guilhermedopp/alerta-calor/hardware/README.md

# Hardware

- `mapa_protoboard_bancada.png`: ligações da montagem de bancada (ESP32 DevKit plugado na protoboard, DHT11 no D26, PIR no D27, buzzer no D25).
- `tutorial_montagem_bancada.pdf`: passo a passo da montagem física da bancada.

- [`kicad/`](kicad/): placa de circuito da caixa (KiCad 10), 40 × 30 mm, já roteada.

**Placa final (caixa v4):** ESP32-C3 SuperMini, sensor AHT20 + BMP280, LED RGB difuso, buzzer ativo 5 V, botão 12 × 12 mm e PIR AM312, numa placa de circuito própria com o ESP32 em soquete. Peças compradas para 3 protótipos (recebidas em 09/11/2026); cada caixa sai por cerca de R$ 35 a 44 em peças.
