guilhermedopp/alerta-calor/caixa_3d/README.md

# Caixa v4 (70 × 69 × 40 mm)

Caixa para impressão 3D, com encaixes impressos junto com o corpo e a tampa para a placa perfurada, o sensor AHT20, o buzzer e o PIR (sem parafusos na placa).

- `imprimir/`: STL do corpo, tampa, painel e disco.
- `imagens/aparencia_caixa_v4.png`: aparência por fora e com os componentes.
- `imagens/medidas_caixa_v4.png`: desenho cotado (frente, lateral e tampa).
- `imagens/encaixes_internos_v4.png`: encaixes por dentro.
- `LEIA-ME_v4b.txt`: o que mudou em relação à v3 e a ordem de montagem.
