guilhermedopp/alerta-calor/docs/README.md

# Documentos

- `Proposta_AI4Good_Alerta_de_Calor.pdf`: proposta do projeto (problema, solução, impacto, plano e limitações).
- `Implementacao_IA_Alerta_de_Calor.pdf`: documento técnico de como as duas IAs serão implementadas.
