guilhermedopp/alerta-calor/caixa_3d/imagens/encaixes_internos_v4.png

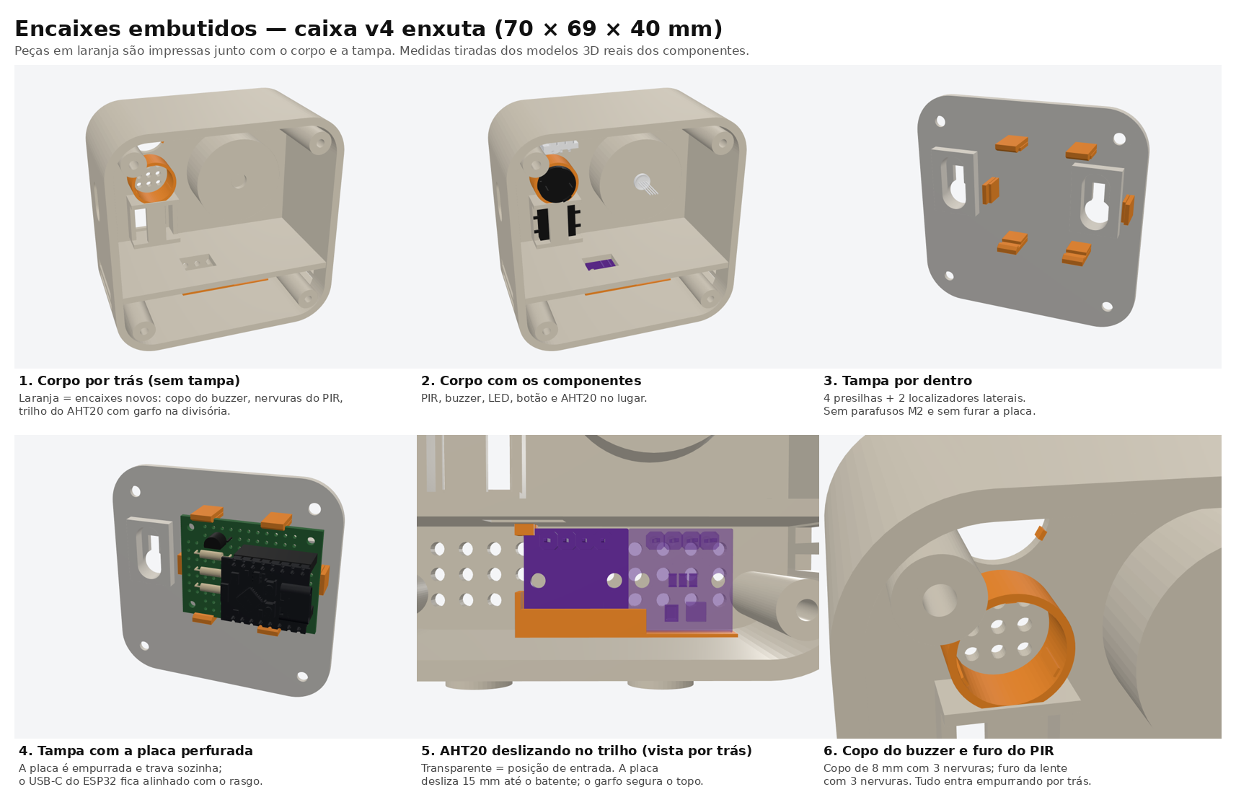
caixa_3d/imagens/encaixes_internos_v4.png
