guilhermedopp/alerta-calor/caixa_3d/imagens/medidas_caixa_v4.png

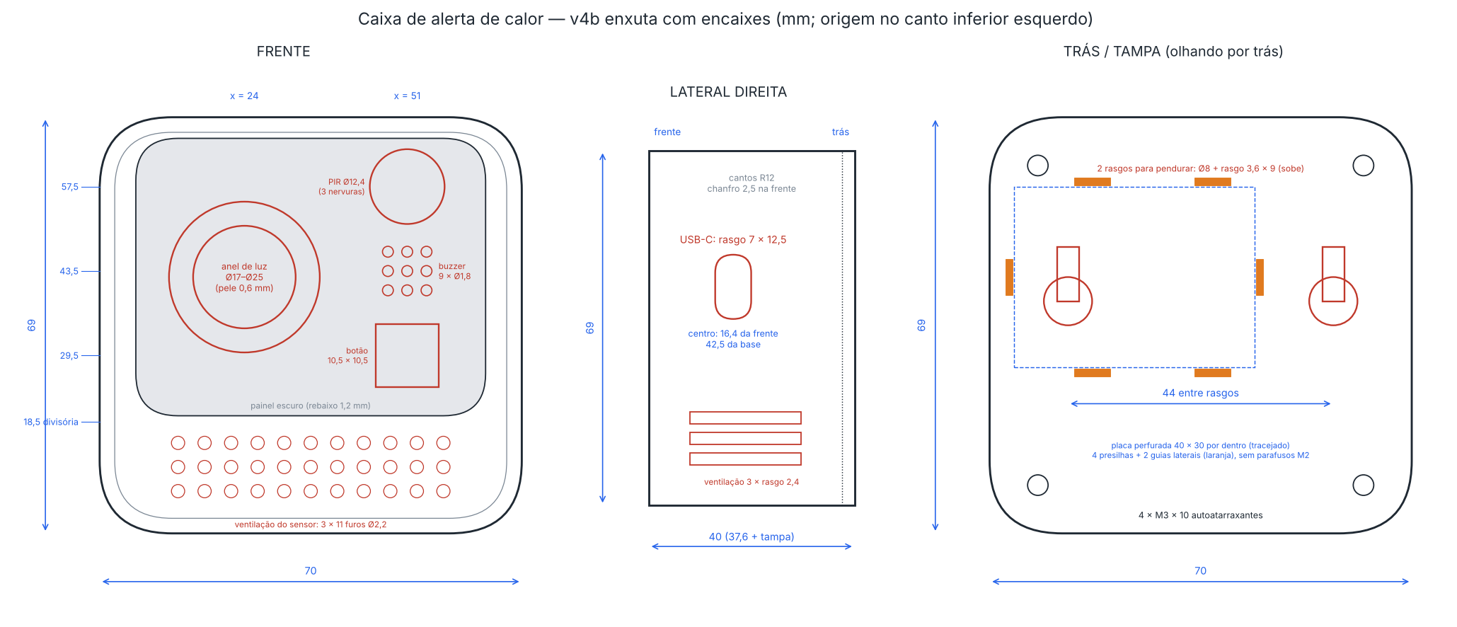
caixa_3d/imagens/medidas_caixa_v4.png
