guilhermedopp/alerta-calor/hardware/mapa_protoboard_bancada.png

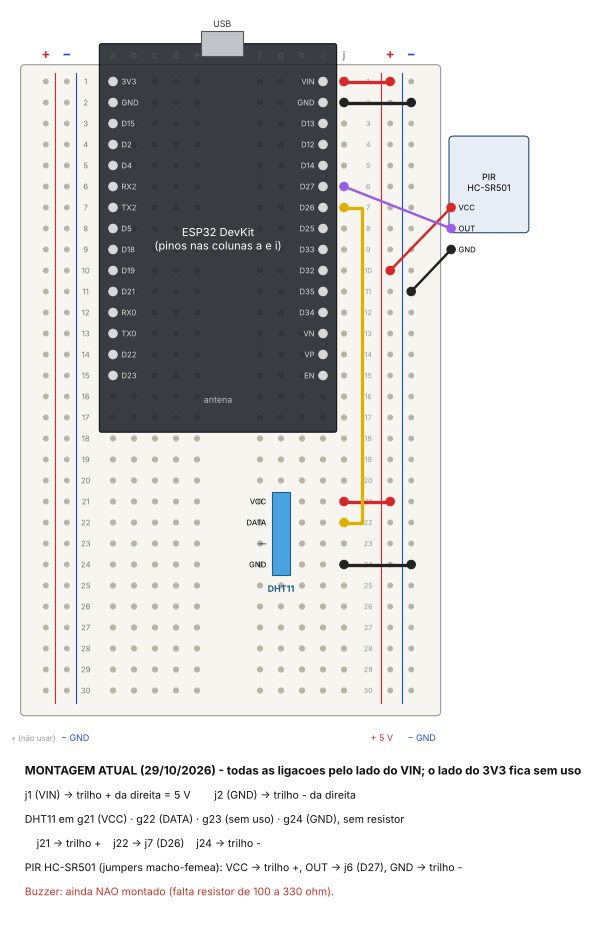
hardware/mapa_protoboard_bancada.png
