guilhermedopp/alerta-calor/caixa_3d/imprimir/caixa_alerta_corpo_v4b.stl

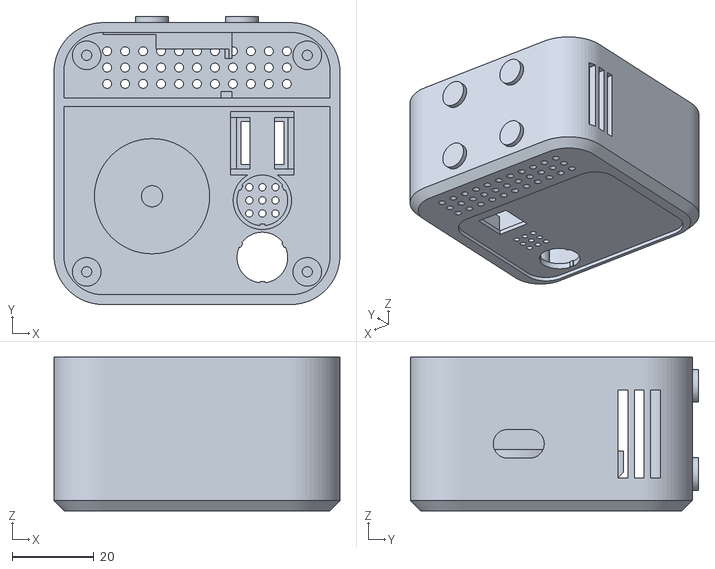
[picture p10: CAD file, 2026-10-30]
caixa_3d/imprimir/caixa_alerta_corpo_v4b.stl
70.0 x 70.5 x 37.6
