guilhermedopp/alerta-calor/caixa_3d/imprimir/caixa_alerta_disco_v4b.stl

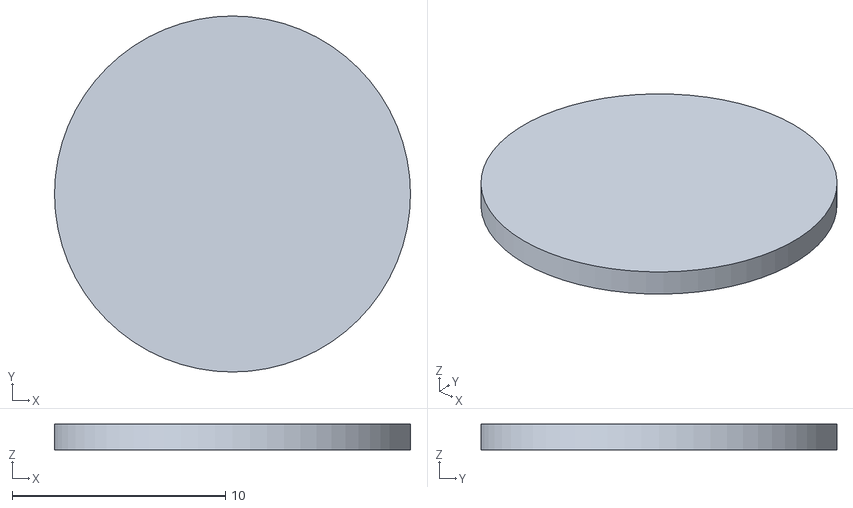
[picture p11: CAD file, 2026-10-30]
caixa_3d/imprimir/caixa_alerta_disco_v4b.stl
16.7 x 16.7 x 1.20
