guilhermedopp/alerta-calor/caixa_3d/imprimir/caixa_alerta_painel_v4b.stl

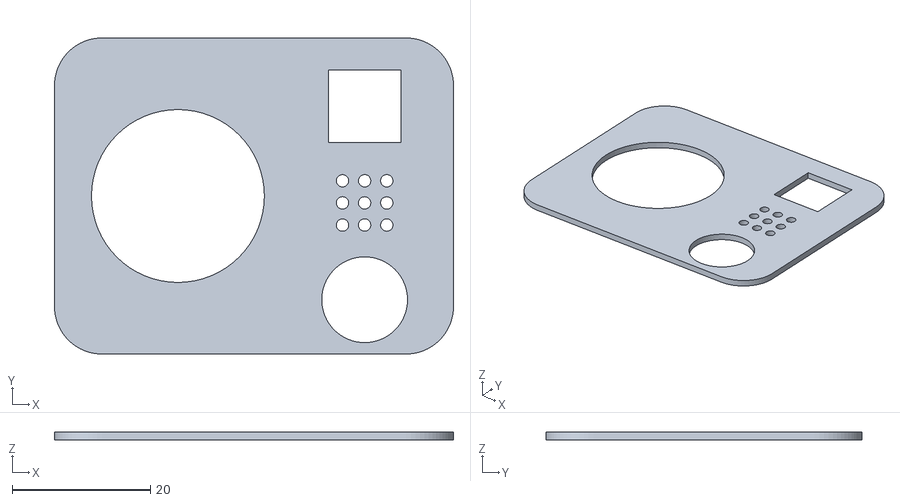
[picture p12: CAD file, 2026-10-30]
caixa_3d/imprimir/caixa_alerta_painel_v4b.stl
57.7 x 45.7 x 1.20
