guilhermedopp/alerta-calor/caixa_3d/imprimir/caixa_alerta_tampa_v4b.stl

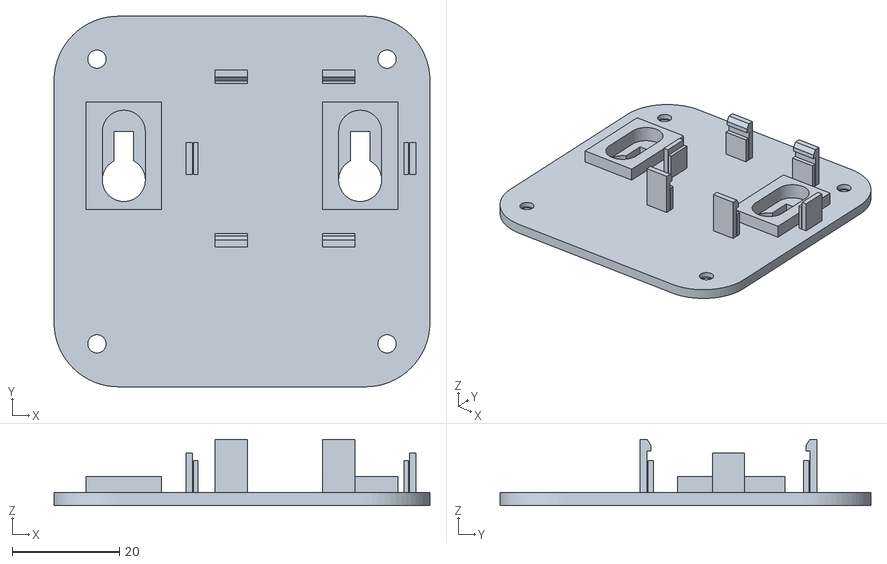
[picture p13: CAD file, 2026-10-30]
caixa_3d/imprimir/caixa_alerta_tampa_v4b.stl
70.0 x 69.0 x 12.3
