guilhermedopp/alerta-calor/analise_maceio/resultados/resultados_poisson.csv

desfecho | exposicao | n_dias | RR | IC95_inf | IC95_sup | p
Circulatórias | tmax | 3338 | 1.0083863294249602 | 0.9960839506184546 | 1.0208406517741808 | 0.1823724984077736
Circulatórias | tmax_l02 | 3317 | 1.006322028506237 | 0.9904987706607143 | 1.0223980635345917 | 0.43575785036854253
Circulatórias | icmax_l02 | 2755 | 1.0098879071161362 | 0.9976052466841611 | 1.0223217934441147 | 0.1150324009631648
Circulatórias | dia_quente | 3338 | 1.0421193254281358 | 0.9660429692794495 | 1.1241867318187988 | 0.2860886018394475
Respiratórias | tmax | 3338 | 0.9953907318713809 | 0.9762769008901077 | 1.0148787789530735 | 0.64048730279358
Respiratórias | tmax_l02 | 3317 | 0.993555902865077 | 0.9689019654138391 | 1.0188371655293358 | 0.6140558981899931
Respiratórias | icmax_l02 | 2755 | 0.9975095194947086 | 0.978414461937185 | 1.0169772424586727 | 0.8003736145411117
Respiratórias | dia_quente | 3338 | 1.0218007605880812 | 0.9079052486601809 | 1.1499843137586794 | 0.7205883454460154
Insuficiência renal aguda | tmax | 3338 | 1.0290482283915852 | 0.9412407259742056 | 1.1250472138887027 | 0.529185084653283
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
