guilhermedopp/alerta-calor/ia/resultados/fig_erros.png

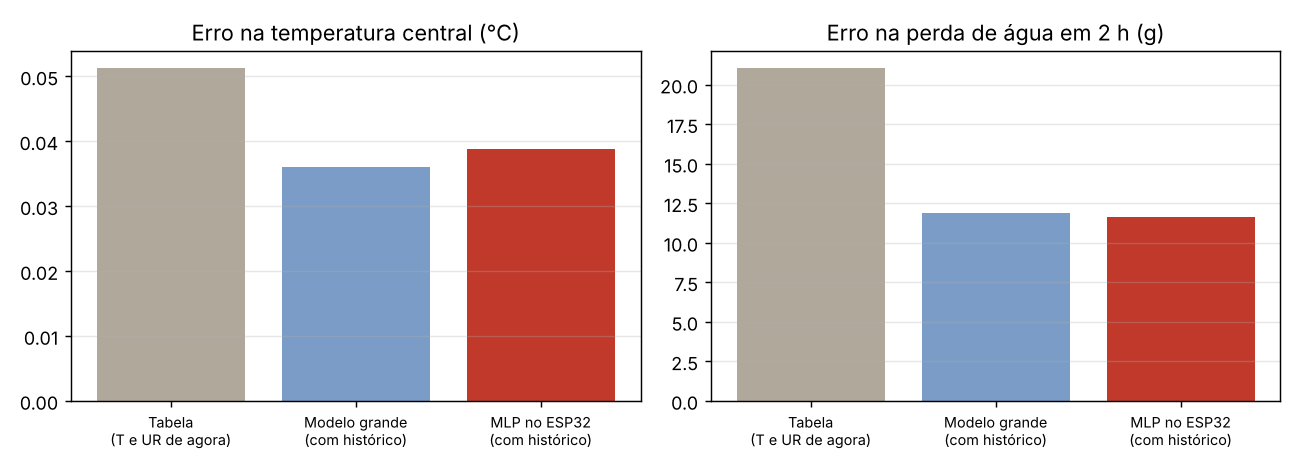
ia/resultados/fig_erros.png
