guilhermedopp/alerta-calor/analise_maceio/internacoes_calor_maceio_diario.csv

data | calor_direto | desidratacao_renal | respiratoria | circulatoria | total
2015-01-01 | 0 | 0 | 0 | 7 | 10
2015-01-02 | 0 | 0 | 1 | 5 | 17
2015-01-03 | 0 | 0 | 0 | 2 | 9
2015-01-04 | 0 | 1 | 3 | 2 | 18
2015-01-05 | 0 | 0 | 3 | 12 | 31
2015-01-06 | 0 | 0 | 5 | 7 | 28
2015-01-07 | 0 | 1 | 1 | 9 | 24
2015-01-08 | 0 | 0 | 3 | 6 | 21
2015-01-09 | 0 | 0 | 1 | 6 | 20
2015-01-10 | 0 | 1 | 3 | 3 | 16
2015-01-11 | 0 | 0 | 1 | 2 | 9
2015-01-12 | 0 | 0 | 3 | 4 | 25
2015-01-13 | 0 | 0 | 1 | 6 | 17
2015-01-14 | 0 | 0 | 2 | 8 | 34
2015-01-15 | 0 | 0 | 2 | 9 | 31
2015-01-16 | 0 | 2 | 3 | 4 | 24
2015-01-17 | 0 | 0 | 5 | 7 | 19
2015-01-18 | 0 | 0 | 2 | 4 | 7
2015-01-19 | 0 | 1 | 1 | 11 | 26
2015-01-20 | 0 | 0 | 2 | 9 | 31
2015-01-21 | 0 | 0 | 1 | 5 | 23
2015-01-22 | 0 | 0 | 5 | 12 | 35
2015-01-23 | 0 | 1 | 1 | 7 | 22
2015-01-24 | 0 | 0 | 1 | 3 | 13
2015-01-25 | 0 | 0 | 1 | 7 | 9
2015-01-26 | 0 | 0 | 2 | 4 | 27
2015-01-27 | 0 | 0 | 4 | 4 | 29
2015-01-28 | 0 | 0 | 1 | 7 | 23
2015-01-29 | 0 | 0 | 3 | 8 | 25
2015-01-30 | 0 | 0 | 2 | 3 | 23
2015-01-31 | 0 | 0 | 2 | 3 | 15
2015-02-01 | 0 | 0 | 3 | 8 | 19
2015-02-02 | 0 | 0 | 3 | 8 | 16
2015-02-03 | 0 | 0 | 2 | 3 | 21
2015-02-04 | 0 | 0 | 4 | 11 | 34
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
