guilhermedopp/alerta-calor/hardware/kicad/alerta_calor.kicad_pcb

## KiCad design hardware/kicad/alerta_calor.kicad_pcb (2026-11-13)

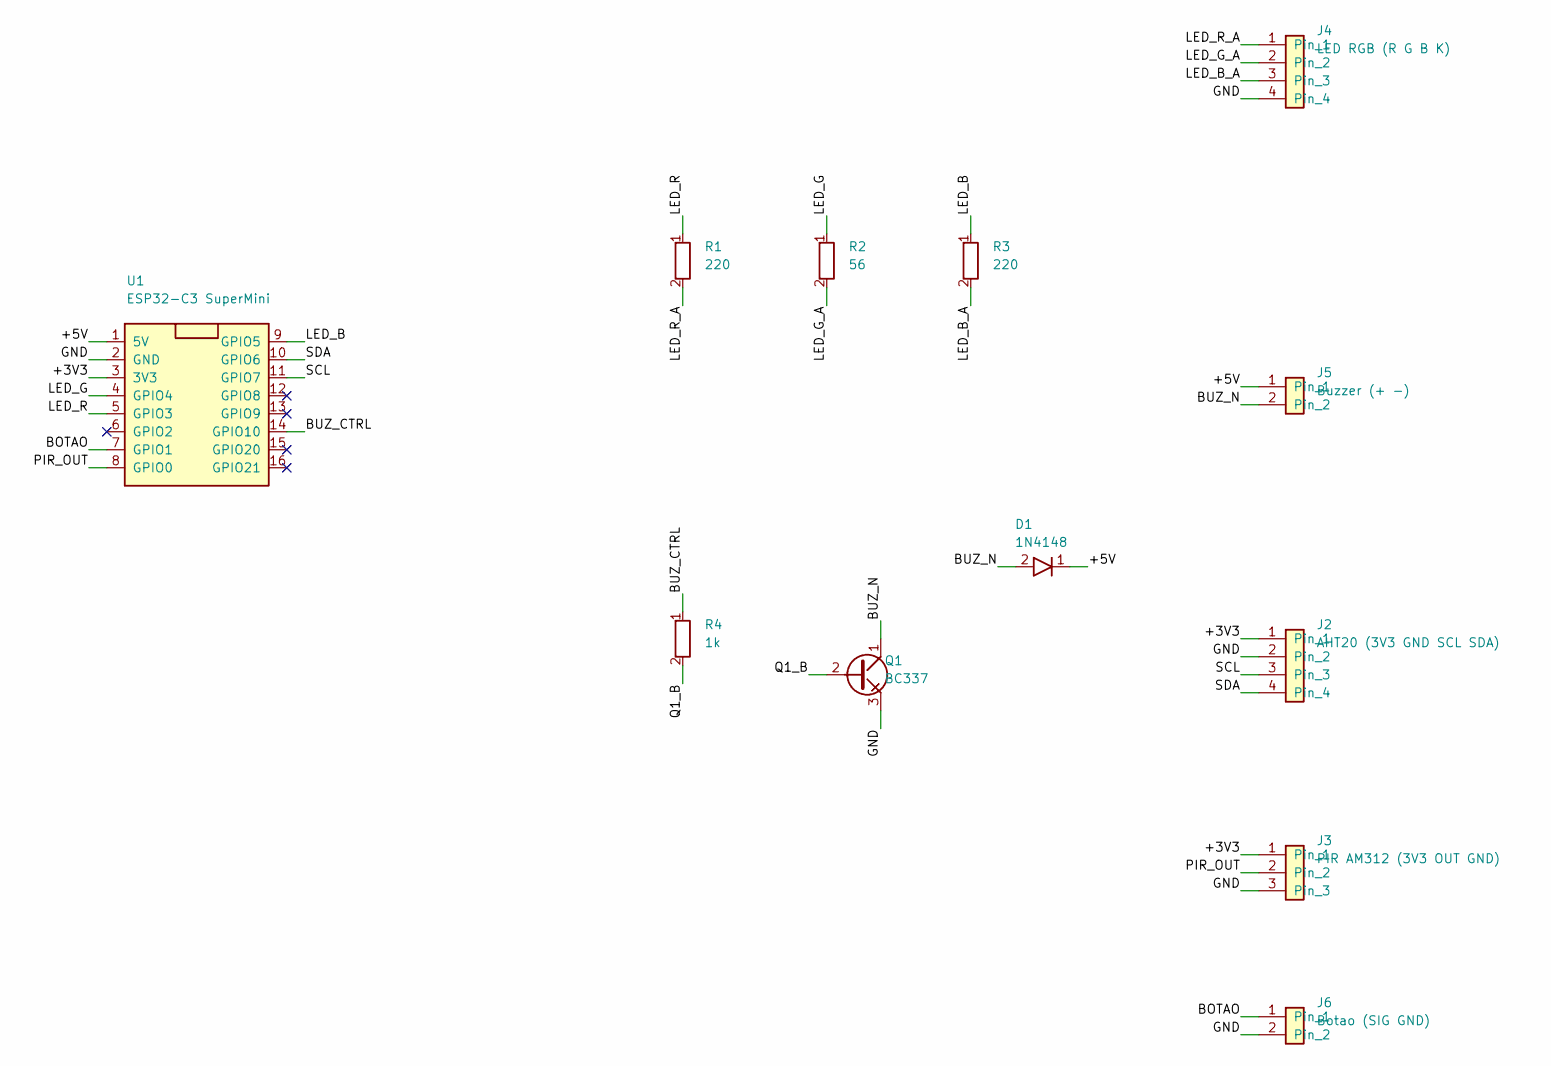
[picture p16: schematic alerta_calor.kicad_sch, Alerta de calor - placa principal]

Parts:
D1: 1N4148; D_DO-35_SOD27_P7.62mm_Horizontal
J2: AHT20 (3V3 GND SCL SDA); PinHeader_1x04_P2.54mm_Vertical
J3: PIR AM312 (3V3 OUT GND); PinHeader_1x03_P2.54mm_Vertical
J4: LED RGB (R G B K); PinHeader_1x04_P2.54mm_Vertical
J5: Buzzer (+ -); PinHeader_1x02_P2.54mm_Vertical
J6: Botao (SIG GND); PinHeader_1x02_P2.54mm_Vertical
Q1: BC337; TO-92_Inline
R1, R3: 220; R_Axial_DIN0207_L6.3mm_D2.5mm_P7.62mm_Horizontal
R2: 56; R_Axial_DIN0207_L6.3mm_D2.5mm_P7.62mm_Horizontal
R4: 1k; R_Axial_DIN0207_L6.3mm_D2.5mm_P7.62mm_Horizontal
U1: ESP32-C3 SuperMini; ESP32-C3_SuperMini_Soquete

Connections:
/+3V3: J2.1, J3.1, U1.3 (3V3)
/+5V: D1.1 (K), J5.1, U1.1 (5V)
/BOTAO: J6.1, U1.7 (GPIO1)
/BUZ_CTRL: R4.1, U1.14 (GPIO10)
/BUZ_N: D1.2 (A), J5.2, Q1.1 (C)
/GND: J2.2, J3.3, J4.4, J6.2, Q1.3 (E), U1.2 (GND)
/LED_B: R3.1, U1.9 (GPIO5)
/LED_B_A: J4.3, R3.2
/LED_G: R2.1, U1.4 (GPIO4)
/LED_G_A: J4.2, R2.2
/LED_R: R1.1, U1.5 (GPIO3)
/LED_R_A: J4.1, R1.2
/PIR_OUT: J3.2, U1.8 (GPIO0)
/Q1_B: Q1.2 (B), R4.2
/SCL: J2.3, U1.11 (GPIO7)
/SDA: J2.4, U1.10 (GPIO6)

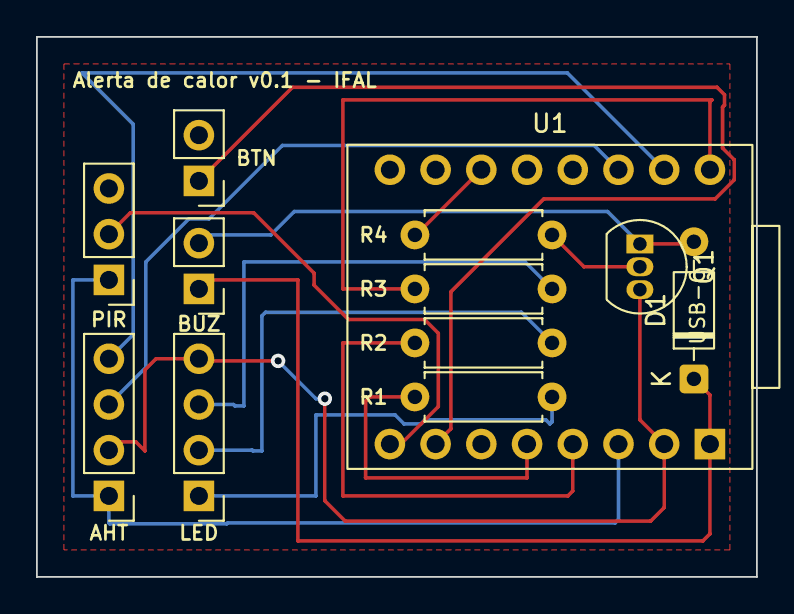
[picture p17: board alerta_calor.kicad_pcb from above]

Board: 2 copper layers, 40.0 x 30.0 mm, 12 parts (0 on the bottom side), 16 nets.
