guilhermedopp/alerta-calor/firmware/bancada_devkit_etapa11/modelo_risco.h

// modelo_risco.h - gerado por treinar.py (MLP treinada com simulacoes JOS-3)
// Entradas: T_agora, UR_agora, T_media_30min, T_media_1h, T_media_2h, T_media_4h, UR_media_2h, T_max_2h, T_variacao_1h, perfil_acamado, perfil_repouso, perfil_ativo
// Saidas: [0] aumento da temperatura central (C) em relacao ao basal; [1] perda de agua por suor nas ultimas 2 h (g)
#pragma once
const int MR_N_IN = 12;
const float MR_X_MEDIA[] = {29.68369f, 62.88364f, 29.57619f, 29.42711f, 29.1679f, 28.80208f, 63.65533f, 30.07059f, 0.6395641f, 0.3238994f, 0.327044f, 0.3490566f};
const float MR_X_ESCALA[] = {3.160524f, 13.88282f, 3.138119f, 3.084982f, 2.932327f, 2.597797f, 13.57306f, 3.115106f, 1.2566f, 0.4679621f, 0.4691335f, 0.4766719f};
const float MR_Y_MEDIA[] = {0.07975105f, 139.294f};
const float MR_Y_ESCALA[] = {0.1418925f, 88.88146f};
const int MR_N_CAMADAS = 3;
const int MR_TAM[] = {12, 16, 16, 2};
const float MR_W0[] = {0.02332856f, 0.1791069f, 0.1179589f, 0.288721f, 0.02936075f, 0.1572466f, -0.08160012f, 0.2512623f, 0.1083208f, -0.1443757f, 0.3598823f, 0.0553268f, -0.02108041f, 0.5606401f, -0.08143052f, 0.01547436f, -0.4345943f, 0.2590913f, 0.07923142f, 0.3140011f, 0.5568046f, 0.2116083f, 0.1567688f, 0.1006617f, -0.1414997f, -0.1279284f, -0.2128823f, 0.2614244f, 0.07626874f, 0.2128044f, -0.1563557f, -0.006917278f, 0.05304728f, 0.02501752f, -0.172557f, 0.2423466f, 0.1015505f, 0.2444493f, 0.3527582f, 0.3985517f, -0.3455758f, -0.097734f, 0.1803543f, -0.4331647f, 0.08805786f, 0.2695393f, -0.1993897f, -0.09934194f, -0.02808263f, -0.2007647f, 0.3820953f, 0.0186037f, 0.4197646f, -0.1749959f, -0.3356659f, 0.1791306f, -0.08225283f, -0.2784965f, -0.01010029f, -0.3272376f, -0.1550448f, -0.2462572f, 0.009332159f, -0.3092365f, -0.1507489f, 0.3090836f, 0.658607f, -0.5198785f, 0.4899891f, 0.03133328f, 0.7427527f, 0.3694063f, 0.523662f, -0.03256493f, 0.4586606f, -0.4895008f, -0.04738933f, -0.05007366f, -0.5853804f, -0.5023627f, -0.1919031f, 0.2513588f, -0.9844117f, 0.3843779f, 0.3586566f, -0.60769f, 0.3304026f, -1.398635f, -0.1288425f, 0.4339308f, 0.225228f, 0.5802539f, -0.8037855f, 0.3169676f, -0.2483938f, -0.7343213f, -0.4102073f, -0.5315084f, 0.1335974f, -0.07829162f, 0.5281412f, -0.3222084f, -0.05494601f, -0.04682219f, -0.3557861f, 0.0684016f, 0.1058697f, 0.3254706f, -0.1086975f, 0.6581806f, 0.07239652f, 0.05167618f, 0.5572707f, -0.2545167f, 0.2188853f, 0.08363952f, 0.2155443f, -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
      for (int i = 0; i < nin; i++) s += a[i] * W[c][i * nout + o];
      z[o] = (c < MR_N_CAMADAS - 1 && s < 0) ? 0 : s;
    }
    for (int o = 0; o < nout; o++) a[o] = z[o];
  }
  for (int o = 0; o < MR_TAM[MR_N_CAMADAS]; o++) y_out[o] = a[o] * MR_Y_ESCALA[o] + MR_Y_MEDIA[o];
}
