guilhermedopp/alerta-calor/(commit log)

2026-10-30 Primeira versão: firmware de bancada, IA embarcada, assistente, caixa 3D e análise
    - firmware/: firmware de bancada da Etapa 11 (ESP32 DevKit), módulo da IA e testes de bancada
    - ia/: simulações JOS-3, treino, avaliação, verificação do C, dados e figuras
    - assistente/: esquema do Supabase, regras de segurança e perguntas de teste
    - caixa_3d/: STL e imagens da caixa v4
    - hardware/, analise_maceio/, docs/
    Claude-Session: https://claude.ai/code/session_015VZPBFVcd2KZd4qGdf2Dom
    [caixa_alerta_corpo_v4b.stl, caixa_alerta_disco_v4b.stl, caixa_alerta_painel_v4b.stl, caixa_alerta_tampa_v4b.stl, internacoes_calor_maceio_diario.csv, resultados_poisson.csv]
2026-11-10 Placa de circuito no KiCad (rev 0.1, roteada)
    Esquema, placa 40 x 30 mm roteada em 2 faces com plano de GND,
    bibliotecas do ESP32-C3 SuperMini e imagens 3D. Ignora arquivos
    locais e temporários do KiCad.
    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
    [alerta_calor.kicad_pcb, alerta_calor.kicad_sch]
2026-11-12 Placa: nomes R1-R4 ao lado das ilhas
    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
    [alerta_calor.kicad_pcb]
2026-11-12 Placa: corrige as fileiras do ESP32-C3 SuperMini (placa espelhada em Y)
    O footprint tinha 5V/GND/3V3 na fileira errada (conferido com a peça
    real). Placa espelhada em torno do centro: mesmas trilhas e ligações.
    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
    [alerta_calor.kicad_pcb]
2026-11-13 Placa: trilhas de 0,2 mm para fabricar no IFAL
    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
    [alerta_calor.kicad_pcb]
